marangisto/Waves/render-front-2.png

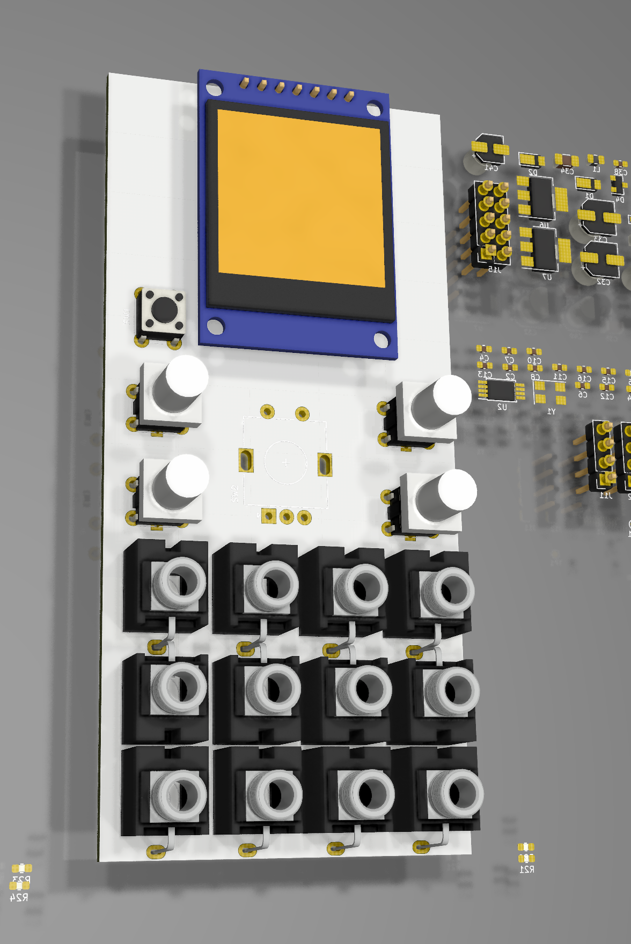
render-front-2.png
