marangisto/Waves/render-back-1.png

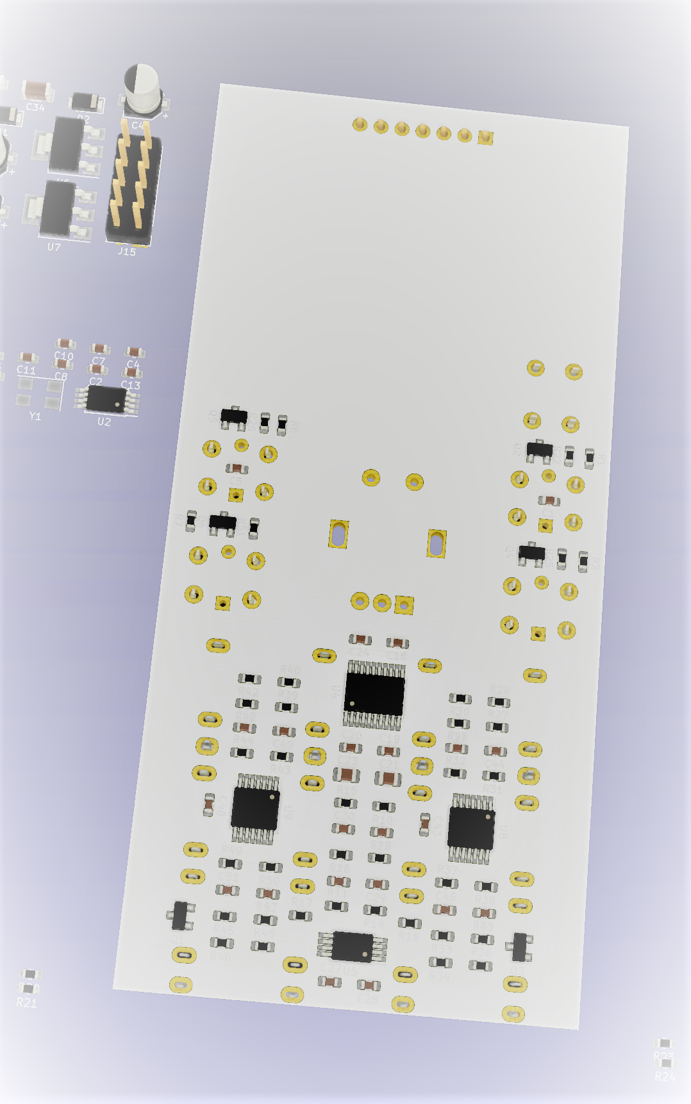
render-back-1.png
