marangisto/Waves/README.md

# Waves
Cordic Accelerated Voltage Controlled Oscillator
