marangisto/Waves/freerouting.png

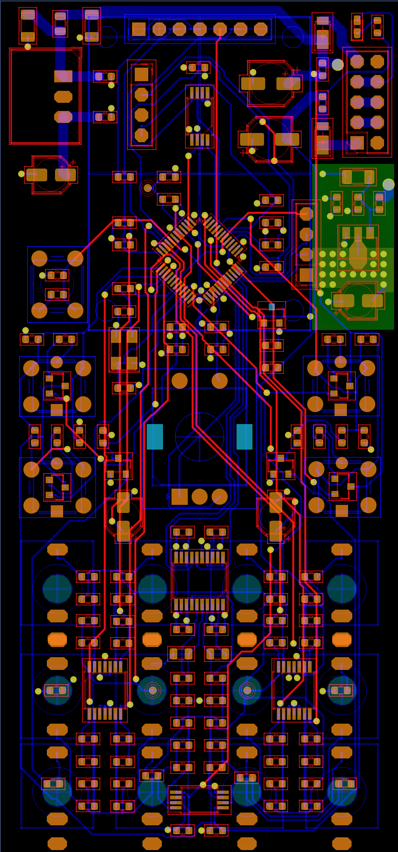
freerouting.png
