marangisto/Waves/remder-back-4.png

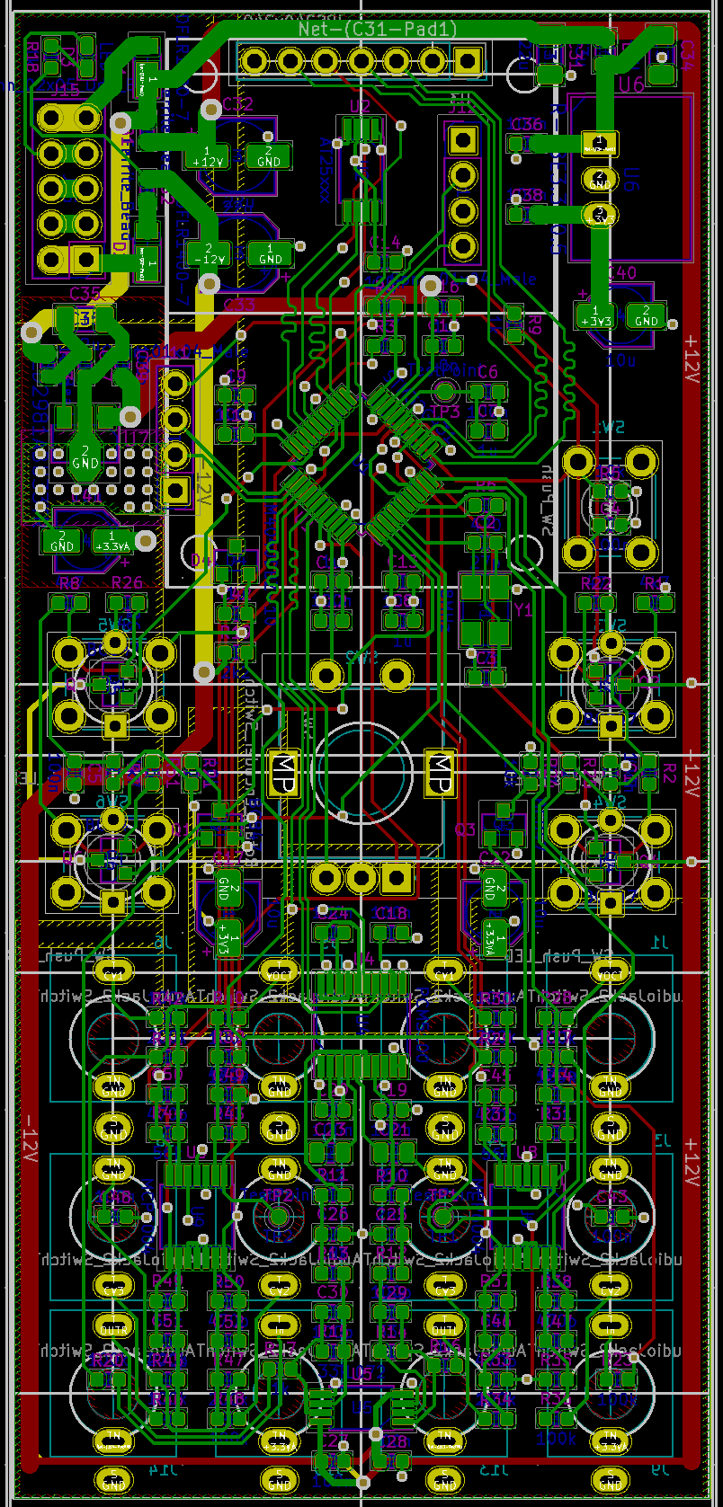
remder-back-4.png
