marangisto/Waves/render-back-2.png

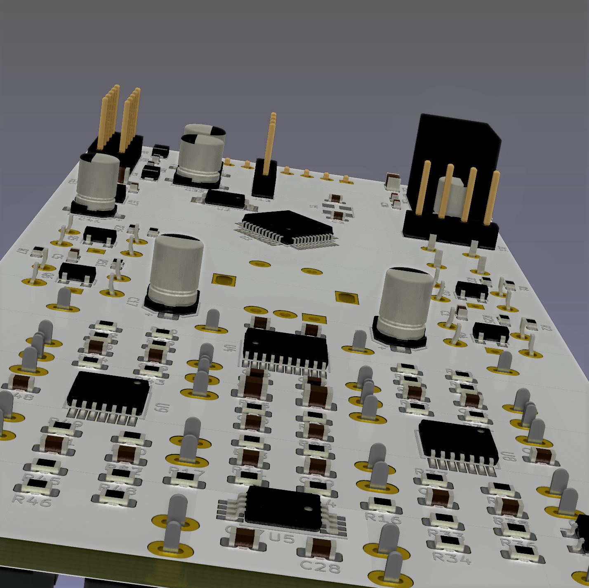
render-back-2.png
