marangisto/Waves/render-back-3.png

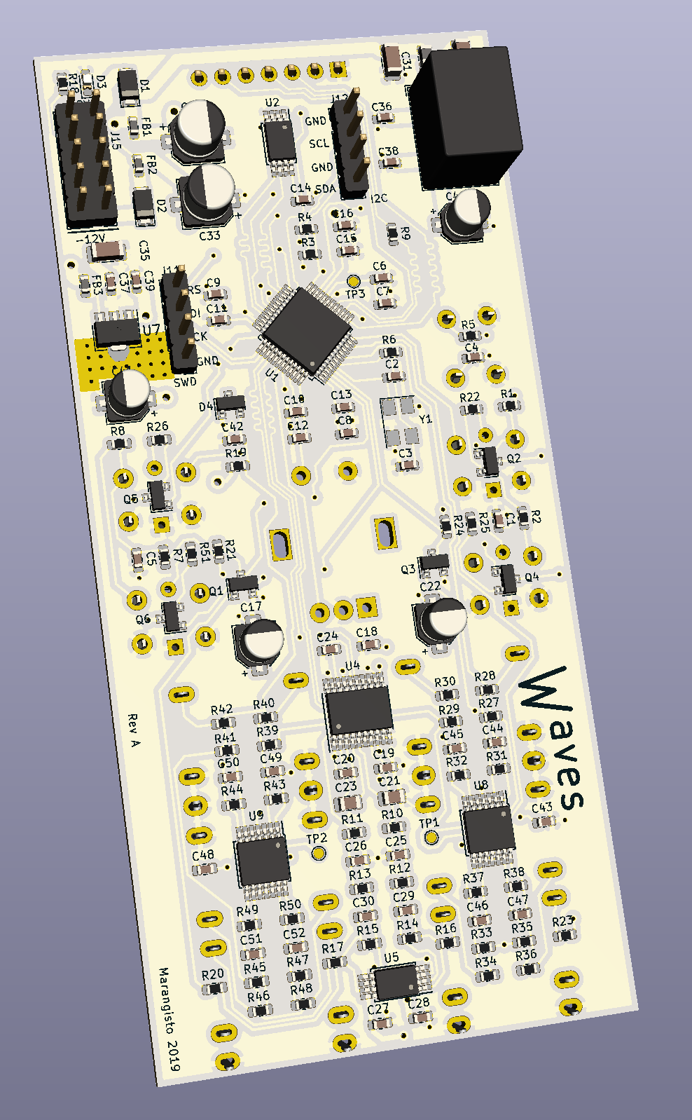
render-back-3.png
