marangisto/Waves/render-front-1.png

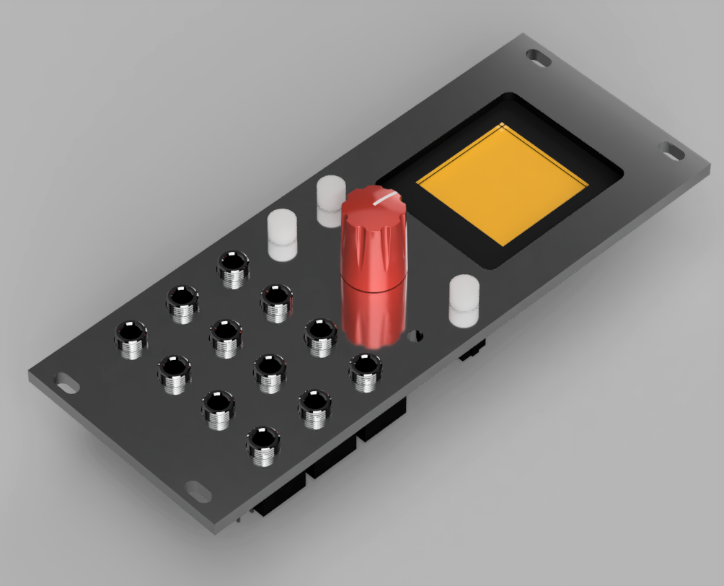
render-front-1.png
