marangisto/Waves/render-panel.png

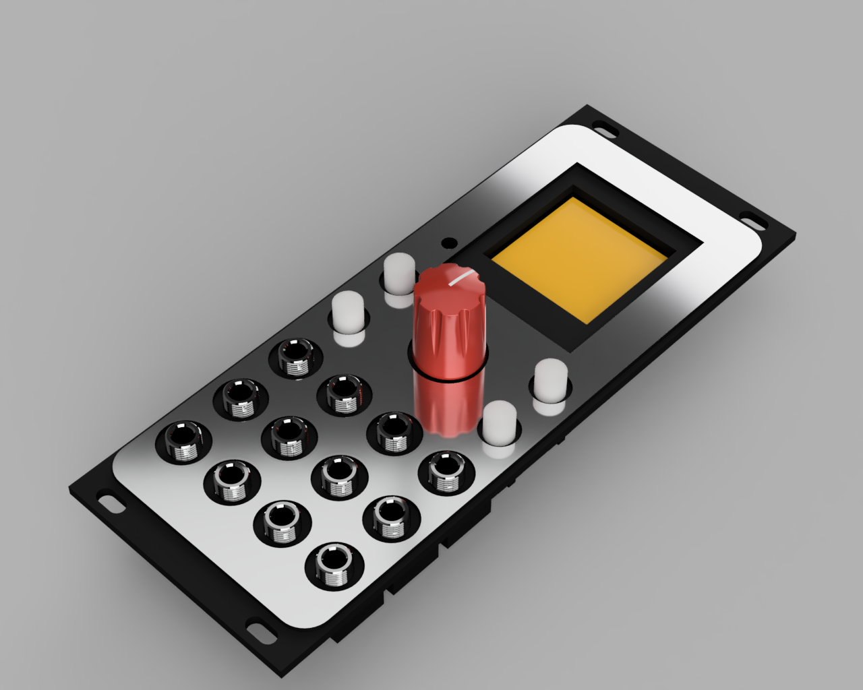
render-panel.png
