marangisto/Waves/drawing.dxf

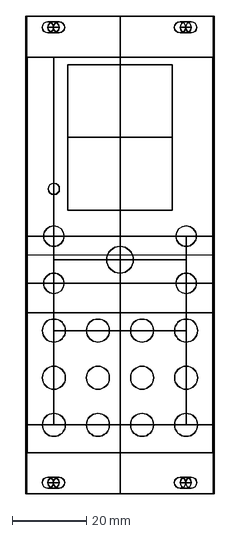
[picture p9: CAD file, 2019-10-22]
drawing.dxf
50.8 x 128.5 mm
