marangisto/Waves/edgecuts.dxf

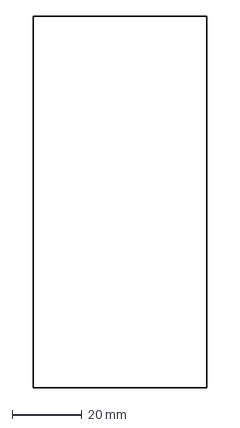
[picture p10: CAD file, 2019-10-20]
edgecuts.dxf
49.8 x 106.5 mm
