marangisto/Waves/tools/Kernel/ChangeLog.md

# Changelog for Kernel

## Unreleased changes
