marangisto/Waves/Spice/CV.asc

C1: cap; 470p
C2: cap; 470p
D1: diode; BZX84B10VL
R1: res; 100k
R2: res; 100k
R3: res; 56k
R4: res; 33k
R5: res; 169k
R6: res; 2.2k
R7: res; 200k
U1: AD8541
U2: AD8541
V1: voltage; 12V
V2: voltage; 12V
V3: voltage; 3.3V
V4: voltage; 5V
Vpwm: voltage; PWL(0 -12 10m 12)
Named nets: 0, PWM, V3V3, V-, V+, CV2, VRef, CV1
.tran 0 10m 0 500n
.include MCP6001.mod
.include LM4040NA10.mod
