marangisto/Waves/Waves.kicad_pcb

## KiCad design Waves.kicad_pcb (2020-12-03)

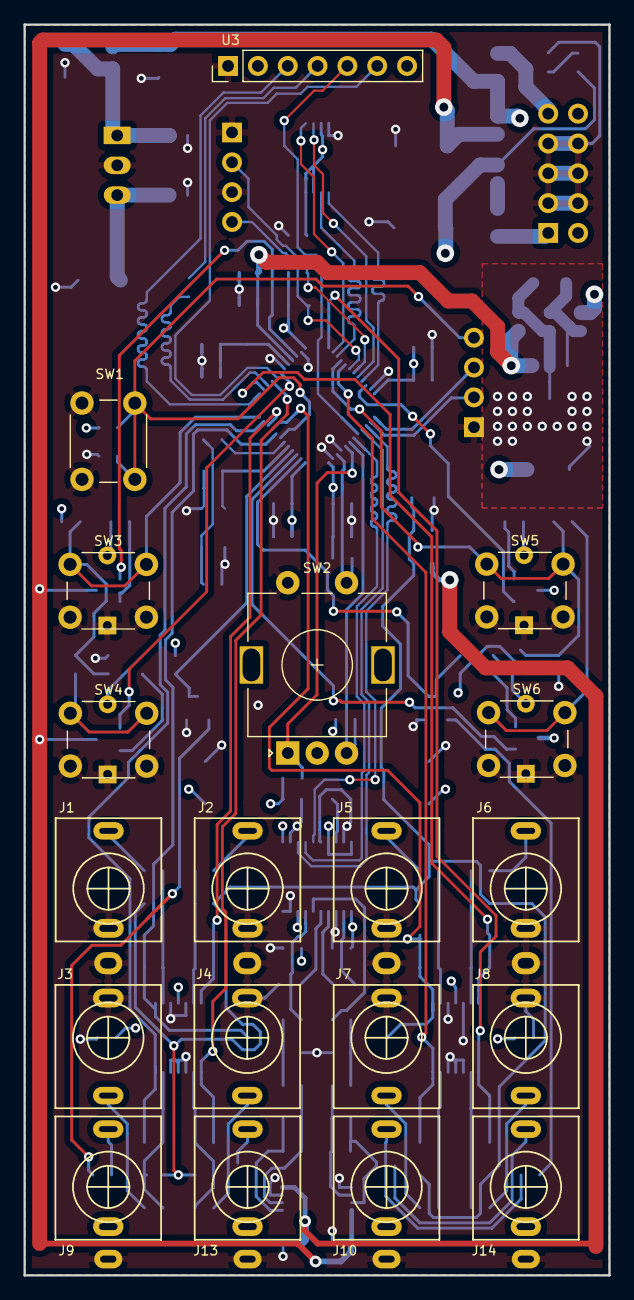
[picture p11: board Waves.kicad_pcb from above]

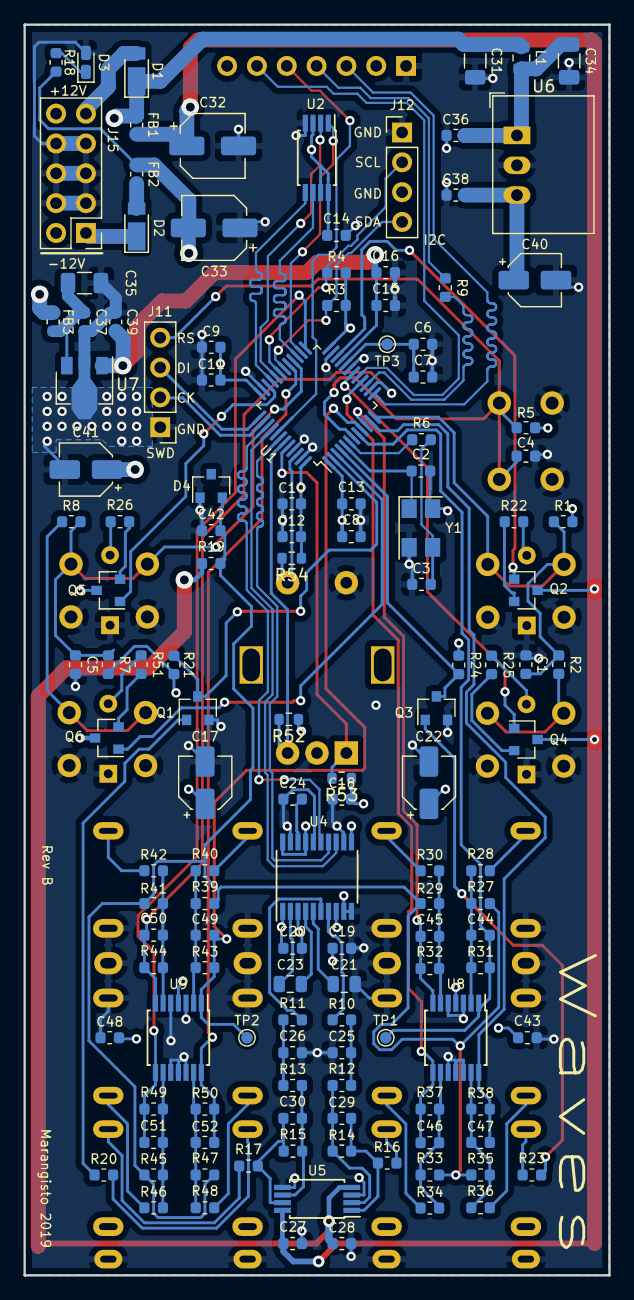
[picture p12: board Waves.kicad_pcb from below]

Board: 4 copper layers, 49.8 x 106.5 mm, 154 parts (135 on the bottom side), 97 nets.

Parts:
C1, C4, C5, C6, C11, C12, C13, C14, C18, C19, C20, C24, C27, C28, C36, C37, C38, C39, C43, C48: 100n; C_0603_1608Metric
C2, C3: 27p; C_0603_1608Metric
C7, C8, C9, C10, C16, C42: 1u; C_0603_1608Metric
C15: 10n; C_0603_1608Metric
C17, C22, C40, C41: 10u; CP_Elec_4x5.8
C21, C23: 2u2; C_0805_2012Metric
C25, C26: 2n2; C_0603_1608Metric
C29, C30: 100p; C_0603_1608Metric
C31, C34, C35: 22u; C_1206_3216Metric
C32, C33: 22u; CP_Elec_5x5.4
C44, C45, C46, C47, C49, C50, C51, C52: 470p; C_0603_1608Metric
D1, D2: DFLR1400-7; D_PowerDI-123
D3: LED; LED_0603_1608Metric_Castellated
D4: LM4040DBZ-10; SOT-23
FB1, FB2, FB3: Ferrite_Bead; L_0603_1608Metric
J1, J2, J3, J4, J5, J6, J7, J8, J9, J10, J13, J14: AudioJack2_SwitchT; PJ398SM
J11, J12: Conn_01x04_Male; PinHeader_1x04_P2.54mm_Vertical
J15: Conn_02x05_Odd_Even; PinHeader_2x05_P2.54mm_Vertical
L1: 33u; L_0805_2012Metric
Q1, Q2, Q3, Q4, Q5, Q6: BC847; SOT-23
R1, R2, R3, R4, R7, R8, R52, R53, R54: 4k7; R_0603_1608Metric
R5, R21, R24: 10k; R_0603_1608Metric
R6, R10, R11: 470; R_0603_1608Metric
R9, R16, R17, R18: 1k; R_0603_1608Metric
R12, R13: 18k; R_0603_1608Metric
R14, R15, R31, R43: 33k; R_0603_1608Metric
R19: 2k2; R_0603_1608Metric
R20, R23, R28, R30, R34, R36, R40, R42, R46, R48: 100k; R_0603_1608Metric
R22, R25, R26, R51: 47; R_0603_1608Metric
R27, R39: 169k; R_0603_1608Metric
R29, R33, R35, R41, R45, R47: 200k; R_0603_1608Metric
R32, R37, R38, R44, R49, R50: 56k; R_0603_1608Metric
SW1: SW_Push; SW_PUSH_6mm
SW2: Rotary_Encoder_Switch; RotaryEncoder_Alps_EC11E-Switch_Vertical_H20mm
SW3, SW4, SW5, SW6: SW_Push_LED; SW_PUSH_LED_6mm
TP1, TP2, TP3: TestPoint; TestPoint_Pad_D1.0mm
U1: STM32G431; LQFP-48_7x7mm_P0.5mm
U2: AT25xxx; TSSOP-8_4.4x3mm_P0.65mm
U3: IPS240x240
U4: PCM5100; TSSOP-20_4.4x6.5mm_P0.65mm
U5: TL072; TSSOP-8_4.4x3mm_P0.65mm
U6: R-78E3.3-0.5; Converter_DCDC_RECOM_R-78E-0.5_THT
U7: LD2981ABU33TR; SOT-89-3
U8, U9: MCP6004; TSSOP-14_4.4x5mm_P0.65mm
Y1: 8MHz; Crystal_SMD_5032-4Pin_5.0x3.2mm

Connections:
+3.3VA: C15.1, C16.1, C19.1, C20.1, C22.1, C39.1, C41.1, C43.1, C48.1, J9.TN, J10.TN, U1.21, U4.1, U4.8, U7.1, U8.4, U9.4
+3V3: C8.1, C9.1, C10.1, C11.1, C12.1, C13.1, C14.1, C17.1, C18.1, C38.1, C40.1, R1.1, R3.1, R4.1, R5.1, R7.1, R21.1, R24.1, R52.1, R53.1, R54.1, U1.1, U1.24, U1.36, U1.48, U2.3, U2.7, U2.8, U3.2, U3.7, U4.11, U4.17, U4.20, U6.3
+12V: C27.1, C32.1, FB1.1, Q2.3, Q4.3, Q5.3, Q6.3, U5.8
-12V: C28.2, C33.2, FB2.1, R18.2, R19.1, U5.4
/DAC/OUTL: J13.T, R16.1
/DAC/OUTR: J14.T, R17.1
/QuadCV/CV1: J2.T, R30.2
/QuadCV/CV2: J3.T, R36.2
/QuadCV/CV3: J4.T, R34.2
/QuadCV/VOCT: J1.T, R28.2
/sheet5DE20AC9/In: J10.T, R20.1
/sheet5E1FC1E7/CV1: J6.T, R42.2
/sheet5E1FC1E7/CV2: J7.T, R48.2
/sheet5E1FC1E7/CV3: J8.T, R46.2
/sheet5E1FC1E7/VOCT: J5.T, R40.2
/sheet5E008663/In: J9.T, R23.1
BTN1: C1.1, R1.2, R2.1, SW3.1, U1.12
BTN2: R2.2, SW4.1
BTN3: C5.1, R7.2, R8.1, SW5.1, U1.28
BTN4: R8.2, SW6.1
CV1A: C44.1, R31.1, TP1.1, U1.8, U8.1
CV1B: C49.1, R43.1, TP2.1, U1.9, U9.1
CV2A: C45.1, R32.1, U1.10, U8.7
CV2B: C50.1, R44.1, U1.14, U9.7
CV3A: C47.1, R38.1, U1.11, U8.14
CV3B: C51.1, R49.1, U1.25, U9.8
CV4A: C46.1, R37.1, U1.16, U8.8
CV4B: C52.1, R50.1, U1.29, U9.14
ENC_CH1: R52.2, SW2.B, U1.43
ENC_CH2: R53.2, SW2.A, U1.44
ENC_SW: R54.2, SW2.S1, U1.46
GND: C1.2, C2.2, C3.2, C4.2, C5.2, C6.2, C7.2, C8.2, C9.2, C10.2, C11.2, C12.2, C13.2, C14.2, C15.2, C16.2, C17.2, C18.2, C19.2, C20.2, C21.2, C22.2, C24.2, C25.2, C26.2, C27.2, C28.1, C31.2, C32.2, C33.1, C34.2, C35.2, C36.2, C37.2, C38.2, C39.2, C40.2, C41.2, C42.2, C43.2, C48.2, D3.2, D4.1, J1.TN, J2.TN, J3.S, J3.TN, J4.S, J4.TN, J5.TN, J6.TN, J7.S, J7.TN, J8.S, J8.TN, J9.S, J10.S, J11.1, J12.1, J12.3, J13.S, J14.S, J15.3, J15.4, J15.5, J15.6, J15.7, J15.8, Q1.2, Q3.2, SW1.1, SW2.C, SW2.S2, SW3.2, SW3.4, SW4.2, SW4.4, SW5.2, SW5.4, SW6.2, SW6.4, U1.19, U1.23, U1.35, U1.45, U1.47, U2.4, U3.1, U4.3, U4.9, U4.10, U4.12, U4.16, U4.19, U5.3, U5.5, U6.2, U7.2, U8.3, U8.5, U8.10, U8.11, U8.12, U9.3, U9.5, U9.10, U9.11, U9.12, Y1.2, Y1.4
I2C_SCL: J12.2, R4.2, U1.31
I2C_SDA: J12.4, R3.2, U1.30
I2S+: U1.42, U4.14
I2S-: U1.40, U4.13
I2S_WS: U1.39, U4.15
LED1: Q2.1, U1.22
LED2: Q4.1, U1.18
LED3: Q5.1, U1.34
LED4: Q6.1, U1.3
MEM_CS: U1.26, U2.1
MEM_MISO: U1.32, U2.2
MEM_MOSI: U1.33, U2.5
MEM_SCK: U1.27, U2.6
unnamed: C2.1, U1.5, Y1.1
unnamed: C3.1, R6.2, Y1.3
unnamed: C21.1, U4.5
unnamed: C23.1, U4.2
unnamed: C23.2, U4.4
unnamed: C24.1, U4.18
unnamed: C25.1, R10.1, R12.2
unnamed: C26.1, R11.1, R13.2
unnamed: C29.1, R14.1, R16.2, U5.1
unnamed: C29.2, R12.1, R14.2, U5.2
unnamed: C30.1, R15.1, R17.2, U5.7
unnamed: C30.2, R13.1, R15.2, U5.6
unnamed: C31.1, D1.1, FB1.2, FB3.2, L1.1
unnamed: C34.1, C36.1, L1.2, U6.1
unnamed: C35.1, C37.1, FB3.1, U7.3
unnamed: C44.2, R27.1, R28.1, R31.2, U8.2
unnamed: C45.2, R29.1, R30.1, R32.2, U8.6
unnamed: C46.2, R33.1, R34.1, R37.2, U8.9
unnamed: C47.2, R35.1, R36.1, R38.2, U8.13
unnamed: C49.2, R39.1, R40.1, R43.2, U9.2
unnamed: C50.2, R41.1, R42.1, R44.2, U9.6
unnamed: C51.2, R45.1, R46.1, R49.2, U9.9
unnamed: C52.2, R47.1, R48.1, R50.2, U9.13
unnamed: D1.2, J15.9, J15.10
unnamed: D2.1, J15.1, J15.2
unnamed: D2.2, FB2.2
unnamed: D3.1, R18.1
unnamed: Q1.1, R20.2
unnamed: Q2.2, R22.2
unnamed: Q3.1, R23.2
unnamed: Q4.2, R25.2
unnamed: Q5.2, R26.2
unnamed: Q6.2, R51.2
unnamed: R6.1, U1.6
unnamed: R9.1, U3.4
unnamed: R10.2, U4.7
unnamed: R11.2, U4.6
unnamed: R22.1, SW3.3
unnamed: R25.1, SW4.3
unnamed: R26.1, SW5.3
unnamed: R51.1, SW6.3
RESET: C4.1, J11.4, R5.2, SW1.2, U1.7
SWCLK: J11.2, U1.38
SWDIO: J11.3, U1.37
TFT+: R9.2, U1.15
TFT-: U1.13, U3.3
TFT_DC: U1.17, U3.6
TFT_RES: U1.41, U3.5
TRIGA: Q3.3, R24.2, U1.4
TRIGB: Q1.3, R21.2, U1.2
VREF: C6.1, C7.1, TP3.1, U1.20
VRef-10: C42.1, D4.2, R19.2, R27.2, R29.2, R33.2, R35.2, R39.2, R41.2, R45.2, R47.2
