marangisto/Waves/src/KarplusStrong/main.cpp

#include <dac.h>
#include <dma.h>
#include <timer.h>
#include <plucked.h>
#include <math.h>

using namespace fixed;

using tim6 = tim_t<6>;
using dac = dac_t<1>;
using dma = dma_t<1>;

static constexpr uint8_t dac_dma_ch = 1;
static constexpr uint16_t buffer_size = 256; // N.B. even!
static constexpr uint16_t half_buffer_size = buffer_size >> 1;
static uint16_t buffer[buffer_size];

using led = output_t<PA5>;
using probe = output_t<PA8>;

static igenerator *g_generator = 0;

template<> void handler<interrupt::DMA1_CH1>()
{
    uint32_t sts = dma::interrupt_status<dac_dma_ch>();

    dma::clear_interrupt_flags<dac_dma_ch>();

    probe::set();

    if (sts & (dma_half_transfer | dma_transfer_complete))
        g_generator->generate
            ( buffer
            + (sts & dma_transfer_complete ? half_buffer_size : 0)
            , half_buffer_size
            , 1
            );

    probe::clear();
}

template<> void handler<interrupt::TIM6_DACUNDER>()
{
    probe::set();
    tim6::clear_update_interrupt_flag();
    probe::clear();
}

int main()
{
    probe::setup();
    led::setup();

    static karplus_strong_t<2048> karplus;

    karplus.setup();
    g_generator = &karplus;

    interrupt::enable();

    dma::setup();
    interrupt::set<interrupt::DMA1_CH1>();

    dac::setup();
    //dac::enable_trigger<1, 5>();    // FIXME: use constant for TIM6_TRGO
    dac::enable_trigger<1, 7>();    // FIXME: use constant for TIM6_TRGO
    dac::enable_dma<1, dma, dac_dma_ch, uint16_t>(buffer, buffer_size);
    dma::enable_interrupt<dac_dma_ch, true>();

    tim6::setup(0, sys_clock::freq() / sample_freq - 1);
    tim6::master_mode<tim6::mm_update>();
    //tim6::enable_update_interrupt();    // enable sampling frequency probe
    //interrupt::set<interrupt::TIM6_DACUNDER>();

    for (float t = .0;; t += 0.3)
      for (unsigned i = 0; i <= 24; ++i)
        {
            led::toggle();
            sys_tick::delay_ms(500);
            g_generator->pitch(0.125 * 440. * pow(2., static_cast<float>(i) / 12.));
            g_generator->modify(1, .5 * (sin(t) + 1.));
            g_generator->trigger();
        }
}
