marangisto/Waves/src/Firmware/classic.h

#pragma once

#include "signal.h"
#include "utils.h"
#include <list.h>

template<typename DISPLAY>
struct oscillator_t
{
    typedef valuebox_t<DISPLAY, show_int> intlabel;
    typedef valuebox_t<DISPLAY, show_float<2>, edit_float<1> > floatbox;
    typedef valuebox_t<DISPLAY, show_waveform, edit_waveform > wavebox;

    void setup(uint8_t i)
    {
        const fontlib::font_t& font = fontlib::cmunvt_28;

        m_opno.setup(font, dark_fg, dark_bg, i);
        m_waveform.setup(font, normal_fg, normal_bg, wf_sine);
        m_weight.setup(font, normal_fg, normal_bg, i ? 0.0f : 1.0f);
        m_ratio.setup(font, normal_fg, normal_bg, 1.0f);
        m_detune.setup(font, normal_fg, normal_bg, 0.0f);
        m_attack.setup(font, normal_fg, normal_bg, 1.0f);
        m_decay.setup(font, normal_fg, normal_bg, 8.0f);
        m_column.setup();
        m_column.append(&m_opno);
        m_column.append(&m_waveform);
        m_column.append(&m_weight);
        m_column.append(&m_ratio);
        m_column.append(&m_detune);
        m_column.append(&m_attack);
        m_column.append(&m_decay);
        m_frame.setup(&m_column, dim_gray);
        m_carrier.setup(440.0f);
        m_carrier.m_waveform = m_waveform.ptr();;
    }

    void render()
    {
        m_frame.render();
    }

    list<ifocus*> navigation()
    {
        list<ifocus*> l;

        l.push_back(&m_waveform);
        l.push_back(&m_weight);
        l.push_back(&m_ratio);
        l.push_back(&m_detune);
        l.push_back(&m_attack);
        l.push_back(&m_decay);
        return l;
    }

    __attribute__((always_inline))
    inline void update(float freq)
    {
        m_carrier.control(freq * m_ratio);
    }

    __attribute__((always_inline))
    inline q31_t sample()
    {
        return response(m_envelope.sample()) * m_carrier.sample();
    }

    __attribute__((always_inline))
    inline void trigger()
    {
        m_envelope.set_a(m_attack * 0.01f);    // FIXME: curve control
        m_envelope.set_d(m_decay * 0.1f);      // FIXME: curve control
        m_envelope.trigger();
    }

    intlabel                                    m_opno;
    wavebox                                     m_waveform;
    floatbox                                    m_weight;
    floatbox                                    m_ratio;
    floatbox                                    m_detune;
    floatbox                                    m_attack;
    floatbox                                    m_decay;
    vertical_t<DISPLAY>                         m_column;
    border_t<DISPLAY>                           m_frame;
    signal_generator_t<classic, SAMPLE_FREQ>    m_carrier;
    ad_envelope_t<SAMPLE_FREQ>                  m_envelope;
};

template<typename DISPLAY>
struct osclabels_t
{
    typedef valuebox_t<DISPLAY, show_str> label;

    void setup()
    {
        const fontlib::font_t& font = fontlib::cmunvt_28;

        m_opno.setup(font, dark_fg, dark_bg, "osc no");
        m_waveform.setup(font, alternate_fg, alternate_bg, "shape");
        m_weight.setup(font, alternate_fg, alternate_bg, "weight");
        m_ratio.setup(font, alternate_fg, alternate_bg, "ratio");
        m_detune.setup(font, alternate_fg, alternate_bg, "detune");
        m_attack.setup(font, alternate_fg, alternate_bg, "attack");
        m_decay.setup(font, alternate_fg, alternate_bg, "decay");
        m_column.setup();
        m_column.append(&m_opno);
        m_column.append(&m_waveform);
        m_column.append(&m_weight);
        m_column.append(&m_ratio);
        m_column.append(&m_detune);
        m_column.append(&m_attack);
        m_column.append(&m_decay);
        m_frame.setup(&m_column, dim_gray);
    }

    void render()
    {
        m_frame.render();
    }

    label               m_opno;
    label               m_waveform;
    label               m_weight;
    label               m_ratio;
    label               m_detune;
    label               m_attack;
    label               m_decay;
    vertical_t<DISPLAY> m_column;
    border_t<DISPLAY>   m_frame;
};

template<typename DISPLAY>
struct classic_t: public screen_t<DISPLAY>, public imodel
{
    enum state_t { navigating, editing };
    static constexpr uint8_t num_ops = 2;
    typedef valuebox_t<DISPLAY, show_str> label;

    void setup()
    {
        m_panel.setup();
        m_labels.setup();
        m_panel.append(&m_labels.m_frame);

        list<ifocus*> navigation;

        for (uint8_t i = 0; i < num_ops; ++i)
        {
            m_ops[i].setup(i);
            m_panel.append(&m_ops[i].m_frame);
            navigation.splice(navigation.end(), m_ops[i].navigation());
        }

        screen_t<DISPLAY>::setup(&m_panel, navigation, normal_cursor, active_cursor);
    }

    // imodel

    virtual void generate(ctrl_t& ctx, int32_t *buf, uint16_t n, uint8_t stride)
    {
        float k = 0.0f;
        q31_t w[num_ops];

        for (uint8_t i = 0; i < num_ops; ++i)
            k += fabsf(m_ops[i].m_weight);

        k = k > 0.0f ? 1.0 / k : 0.0f;

        for (uint8_t i = 0; i < num_ops; ++i)
        {
            w[i] = q31_t(k * m_ops[i].m_weight);
            m_ops[i].update(ctx.freq * (1.0 + 1e-3 * m_ops[i].m_detune));
        }

        for (uint16_t i = 0; i < n; ++i, buf += stride)
        {
            q31_t y = w[0] * m_ops[0].sample() + w[1] * m_ops[1].sample();

            *buf = board::dacdma::swap(y.q);
        }
    }

    virtual void trigger(bool rise)
    {
        if (rise)
            for (uint8_t i = 0; i < num_ops; ++i)
                m_ops[i].trigger();
    }

    osclabels_t<DISPLAY>    m_labels;
    oscillator_t<DISPLAY>   m_ops[num_ops];
    horizontal_t<DISPLAY>   m_panel;
};
