marangisto/Waves/include/signal.h

#pragma once

#include <fixed.h>
#include <cordic.h>

using namespace fixed;

void setup_cordic()
{
    cordic::setup<cordic::sine, 4>();
}

template<typename WAVEGEN, uint32_t SAMPLE_FREQ>
class signal_generator_t: public WAVEGEN
{
public:
    void setup(float freq = 440.)
    {
        m_phi = q31_t::min_val;
        control(freq, 0.0f);
    }

    __attribute__((always_inline))
    inline void control(float freq, float idx = 0.0f)
    {
        float k = 2.0f * freq / SAMPLE_FREQ;

        m_dphi = q31_t(k);
        m_idx = q31_t(k * idx);
    }

    __attribute__((always_inline))
    inline q31_t sample(q31_t mod = q31_t())
    {
        q31_t s = WAVEGEN::value(m_phi);            // generate signal value

        m_phi = m_phi + m_dphi + mod * m_idx;       // advance angle
        return s;
    }

private:
    q31_t           m_phi;
    volatile q31_t  m_dphi;
    volatile q31_t  m_idx;
};

struct sine
{
    inline q31_t value(q31_t phi)
    {
        return q31_t(cordic::compute(phi.q));
    }
};

struct triangle
{
    inline q31_t value(q31_t phi)
    {
        static constexpr q31_t one(q31_t(1.0f));
        static constexpr q31_t half(q31_t(0.5f));

        if (phi < -half)
            return q31_t::lshift(phi + one, 1);
        else if (phi < half)
            return q31_t::lshift(-phi, 1);
        else
            return q31_t::lshift(phi - one, 1);
    }
};

struct sawtooth
{
    inline q31_t value(q31_t phi)
    {
        return phi;
    }
};

struct square
{
    inline q31_t value(q31_t phi)
    {
        return phi < q31_t(0l) ? q31_t::max_val : q31_t::min_val;
    }
};

struct classic
{
    inline q31_t value(q31_t phi)
    {
        switch (*m_waveform)
        {
            case wf_sine: return m_sine.value(phi);
            case wf_triangle: return m_triangle.value(phi);
            case wf_sawtooth: return m_sawtooth.value(phi);
            case wf_square: return m_square.value(phi);
            default: return q31_t(0l);
        }
    }

    const volatile waveform_t   *m_waveform;
    sine                        m_sine;
    triangle                    m_triangle;
    sawtooth                    m_sawtooth;
    square                      m_square;
};
