marangisto/Waves/(commit log)

2019-08-24 Board abstraction with message queue.
2019-08-24 Eliminate encoder double-stepping.
2019-08-25 Added output stage and signal generators.
2019-08-27 Added stm32g431 symbol.
    [CordicVCO.kicad_pcb, CordicVCO.sch]
2019-09-03 Added external cv volt / octave input.
2019-10-19 Assigned some footprints.
    [CordicVCO.sch]
2019-10-19 Moved DAC to separate sheet.
    [CordicVCO.sch, DAC.sch]
2019-10-19 Added power.
    [CordicVCO.sch, DAC.sch, POWER.sch]
2019-10-19 Decoupling caps and voltage reference.
    [CordicVCO.sch, DAC.sch, POWER.sch]
2019-10-20 Major pin-assignments and some IO hardware.
    [CordicVCO.kicad_pcb, CordicVCO.sch, DAC.sch, DigitalIn.sch, POWER.sch, PinAssignment.xlsx, PushLED.sch]
2019-10-20 Assigned ADC inputs and I2C expansion bus.
    [CordicVCO.sch, PinAssignment.xlsx]
2019-10-20 Triggers and buttons.
    [CordicVCO.sch, PinAssignment.xlsx]
2019-10-20 CV inputs, including spice checks.
    [CordicVCO.sch, DAC.sch, POWER.sch, PinAssignment.xlsx, QuadCV.sch]
2019-10-20 Split analog ground and DRC checks.
    [CordicVCO.sch, DAC.sch, DigitalIn.sch, POWER.sch, PushLED.sch, QuadCV.sch]
2019-10-20 Renamed project to Waves.
    [DAC.sch, DigitalIn.sch, POWER.sch, PushLED.sch, QuadCV.sch, Waves.kicad_pcb, Waves.sch]
2019-10-20 Layout and edgecuts.
    [Waves.kicad_pcb, drawing.dxf, edgecuts.dxf]
2019-10-20 Corrected footprints.
    [DAC.sch, DigitalIn.sch, POWER.sch, PushLED.sch, QuadCV.sch, Waves.kicad_pcb, Waves.sch]
2019-10-21 Drawing adjustments.
    [Waves.kicad_pcb, drawing.dxf]
2019-10-21 Placed front-side components.
    [Waves.kicad_pcb]
2019-10-21 Corrected power supply for MCP6004.
    [DAC.sch, DigitalIn.sch, POWER.sch, PushLED.sch, QuadCV.sch, Waves.kicad_pcb, Waves.sch]
2019-10-21 Re-annotated schema.
    [PushLED.sch, QuadCV.sch]
2019-10-21 No split ground.
    [POWER.sch, Waves.kicad_pcb]
2019-10-21 First pass of component placement.
    [Waves.kicad_pcb, Waves.sch]
2019-10-22 Added fourth led-button and movde reset switch.
    [DAC.sch, DigitalIn.sch, POWER.sch, PushLED.sch, QuadCV.sch, Waves.kicad_pcb, Waves.sch, drawing.dxf]
2019-10-22 Placed ADC input stages.
    [Waves.kicad_pcb]
2019-10-22 Placed DAC and output stage.
    [Waves.kicad_pcb]
2019-10-23 Changed regulators and laid out power components.
    [POWER.sch, Waves.kicad_pcb]
2019-10-24 First pass complete layout.
    [DAC.sch, DigitalIn.sch, PushLED.sch, Waves.kicad_pcb, Waves.sch]
2019-10-24 Ground plane and keep-out for jacks.
    [Waves.kicad_pcb]
2019-10-24 Heat-sink for analog supply.
    [Waves.kicad_pcb]
2019-10-24 Pre-routing state.
    [DAC.sch, PushLED.sch, Waves.kicad_pcb, Waves.sch]
2019-10-24 Improved placement and avoidance of criss-crossing.
    [PushLED.sch, QuadCV.sch, Waves.kicad_pcb, Waves.sch]
2019-10-25 Power layer adjustments.
    [Waves.kicad_pcb]
2019-10-25 Via stitch on headsink.
    [Waves.kicad_pcb]
2019-10-25 Swap IC2 and SWD headers.
    [Waves.kicad_pcb]
2019-10-26 Swapped led and trigger pins for better routing.
    [Waves.kicad_pcb, Waves.sch]
2019-10-26 More pin swapping and some power routing.
    [DAC.sch, PushLED.sch, QuadCV.sch, Waves.kicad_pcb]
2019-10-26 Routed and length matched all SPI & I2S lines.
    [PushLED.sch, Waves.kicad_pcb, Waves.sch]
2019-10-26 More power routing.
    [Waves.kicad_pcb]
2019-10-26 Routed I2C and analog power.
    [Waves.kicad_pcb]
2019-10-26 Fully routed, clean DRC.
    [Waves.kicad_pcb]
2019-10-26 Merged pads for jacks.
    [Waves.kicad_pcb]
2019-10-26 Front silkscreen.
    [Waves.kicad_pcb]
2019-10-26 Rear silkscreen.
    [Waves.kicad_pcb]
2019-10-26 Rear ground pour.
    [Waves.kicad_pcb]
2019-10-26 Front and power ground pour.
    [Waves.kicad_pcb]
2019-10-26 Length match interfaces.
    [Waves.kicad_pcb]
2019-10-26 No silk-screen on heat-simk.
    [Waves.kicad_pcb]
2019-10-26 Labels and branding
    [Waves.kicad_pcb]
2019-10-26 More clerance on some mcu traces
    [Waves.kicad_pcb]
2019-10-28 Generated Gerbers.
    [Waves.kicad_pcb]
2019-10-28 Added Gerbers.
    [Waves-B_Cu.gbr, Waves-B_Mask.gbr, Waves-B_Paste.gbr, Waves-B_SilkS.gbr, Waves-Edge_Cuts.gbr, Waves-F_Cu.gbr, Waves-F_Mask.gbr, Waves-F_SilkS.gbr]
2019-10-31 Added BOM.
    [Waves.csv]
2019-11-10 Define actual board pinout.
2019-11-12 Board running with blinking leds 1-4.
2019-11-16 Polling read of button adc channels.
2019-11-16 Second ADC running in DMA mode.
2019-11-17 Swapped channels on adc2 to correct for board layout.
2019-11-23 Work on dac over i2s with dma.
2019-11-23 I2S dac with dma working!
2019-11-25 Use exti interrupts for triggers a & b.
2019-11-26 Separated channel fills with dma interrupts.
2019-11-30 Set frequency inside I2S interrupt handler for more frequent update.
2019-11-30 Added sheet for some calculations.
    [math.xlsx]
2019-12-02 Process encoder and buttons.
2019-12-02 Debounce the button inputs.
2019-12-03 Added dac dma load measurement.
2019-12-10 Swapped channels for correct order to DAC.
    [dacdma.h]
2019-12-11 Corrected encoder direction.
2019-12-17 Partial change to use fix point arithmetic in phase accumulator.
    [main.cpp, signal.h]
2019-12-18 Rewrote exponential response in fixed point.
    [main.cpp, synth.h]
2019-12-18 Fixed point arithmetic for envelope.
    [main.cpp, synth.h]
2019-12-27 Preliminary integration of volt-per-octave core.
2019-12-27 Added board test program.
2019-12-28 Better sharing of control voltage code.
2019-12-28 Basic scales (no modes or variations).
    [math.xlsx]
2020-07-30 Better initial settings and 0V at midi note 57.
2020-07-30 Skeleton calibration model.
2020-08-01 Completed calibration sampling logic.
2020-08-01 Working calibration.
2020-08-23 Created firmware directory.
    [math.xlsx]
2020-08-23 Use corona for build.
    [math.xlsx]
2020-10-22 Added basic dump test for on-board at25.
2020-10-23 Extended calibration strategy.
2020-10-25 Reorganized files for better sharing.
    [build.cfg]
2020-10-27 Compute bucketed averages.
2020-10-28 Bucket results and calibration compare.
2020-10-30 Separate compile board initialization and statics.
2020-11-01 Launch auto-tune when encoder pressed on reset.
    [main.cpp]
2020-11-02 Removed old calibration code.
2020-11-02 Fixed adc to cv translation.
    [board.cpp, tuning.h]
2020-11-12 Pitch control in interface.
2020-11-21 Moved exponential approximation to fixed header.
    [synth.h]
2020-11-28 Renumbred buttons from 1 to allow release encoding.
2020-11-28 Use chromatic quantization for less noise with Karplus-Strong.
    [gui.h]
2020-11-28 Added gate decay (cv-mod not working).
    [main.cpp, plucked.h]
2020-11-29 Fixed decay modulation bug.
    [gui.h, main.cpp, plucked.h]
2020-12-03 Added pull-ups on encoder.
    [DAC.sch, DigitalIn.sch, POWER.sch, PushLED.sch, QuadCV.sch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]
